Oliv4945/Photokey/images/Readme.md

# Setup
Install [PythonMagick] (https://wiki.python.org/moin/ImageMagick) from [source](http://www.imagemagick.org/download/python/) or your distribution package manager.  

* Debian: `apt install python3-pythonmagick`
