Oliv4945/Photokey/documentation/CR2450 holder.jpg

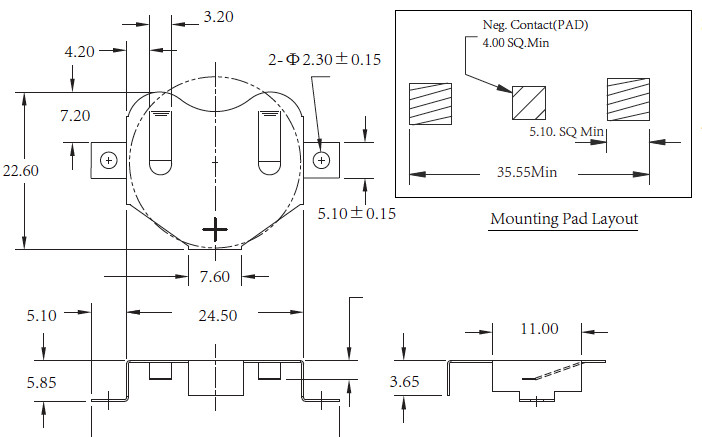
documentation/CR2450 holder.jpg
