Oliv4945/Photokey/hardware/hardware.kicad_pcb

## KiCad design hardware/hardware.kicad_pcb (2019-12-13)

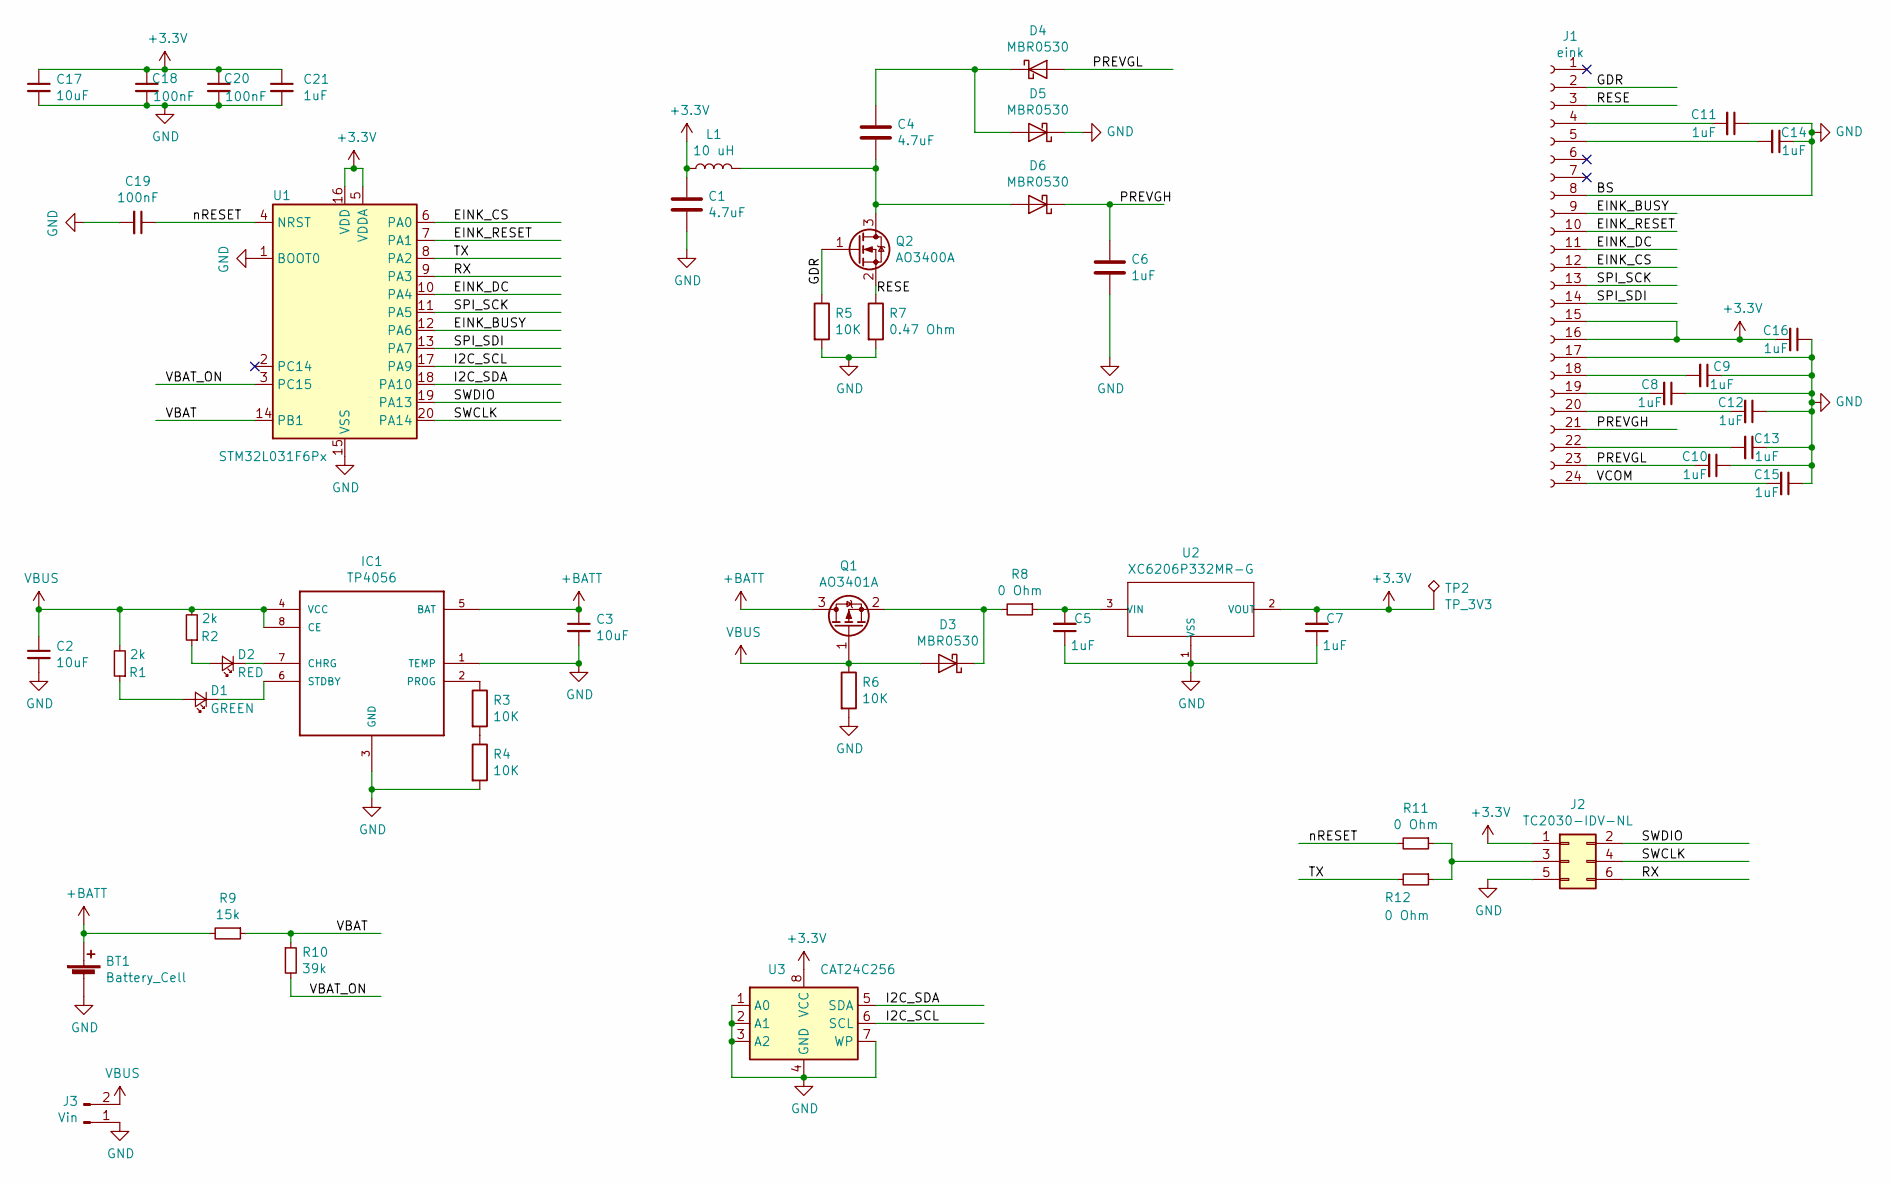
[picture p2: schematic hardware.sch]

Parts:
BT1: Battery_Cell; 2450
C1, C4: 4.7uF; C_1206_3216Metric; LCSC C29823
C2, C3, C17: 10uF; C_0805_2012Metric; LCSC C15850
C5, C6, C7, C8, C9, C10, C11, C12, C13, C14, C15, C16, C21: 1uF; C_0603_1608Metric; LCSC C15849
C18, C19, C20: 100nF; C_0402_1005Metric; LCSC C1525
D1: GREEN; D_0603_1608Metric; LCSC C72043
D2: RED; D_0603_1608Metric; LCSC C2286
D3, D4, D5, D6: MBR0530; D_SOD-123; LCSC C232832
IC1: TP4056; SOP-8; LCSC C16581
J1: eink; FPC_24
J2: TC2030-IDV-NL; TC2030-MCP-NL
J3: Vin; PinHeader_1x02_P2.54mm_Vertical
L1: 10 uH; L_1210_3225Metric; LCSC C86069
Q1: AO3401A; SOT-23; LCSC C15127
Q2: AO3400A; SOT-23; LCSC C20917
R1, R2: 2k; R_0402_1005Metric; LCSC C4109
R3, R4, R5, R6: 10K; R_0402_1005Metric; LCSC C25744
R7: 0.47 Ohm; R_0603_1608Metric; LCSC C23411
R8, R11, R12: 0 Ohm; R_0402_1005Metric; LCSC C21189
R9: 15k; R_0402_1005Metric; LCSC C25756
R10: 39k; R_0402_1005Metric; LCSC C25783
TP2: TP_3V3; TestPoint_Pad_D1.5mm
U1: STM32L031F6Px; TSSOP-20_4.4x6.5mm_P0.65mm; LCSC C115208
U2: XC6206P332MR-G; SOT-23; LCSC C5446
U3: CAT24C256; SOIC-8_3.9x4.9mm_P1.27mm; LCSC C6482

Connections:
+3V3: C1.1, C7.2, C16.2, C17.1, C18.1, C20.1, C21.1, J1.15, J1.16, J2.1, L1.1, TP2.1, U1.5 (VDDA), U1.16 (VDD), U2.2 (VOUT), U3.8 (VCC)
+BATT: BT1.1 (+), C3.1, IC1.5 (BAT), Q1.3 (D), R9.2
/EINK_BUSY: J1.9, U1.12 (PA6)
/EINK_CS: J1.12, U1.6 (PA0)
/EINK_DC: J1.11, U1.10 (PA4)
/EINK_RESET: J1.10, U1.7 (PA1)
/GDR: J1.2, Q2.1 (G), R5.1
/I2C_SCL: U1.17 (PA9), U3.6 (SCL)
/I2C_SDA: U1.18 (PA10), U3.5 (SDA)
/PREVGH: C6.1, D6.1 (K), J1.21
/PREVGL: C10.2, D4.2 (A), J1.23
/RESE: J1.3, Q2.2 (S), R7.1
/RX: J2.6, U1.9 (PA3)
/SPI_SCK: J1.13, U1.11 (PA5)
/SPI_SDI: J1.14, U1.13 (PA7)
/SWCLK: J2.4, U1.20 (PA14)
/SWDIO: J2.2, U1.19 (PA13)
/TX: R12.2, U1.8 (PA2)
/VBAT: R9.1, R10.1, U1.14 (PB1)
/VBAT_ON: R10.2, U1.3 (PC15)
/VCOM: C15.2, J1.24
/nRESET: C19.1, R11.2, U1.4 (NRST)
GND: BT1.2 (-), C1.2, C2.2, C3.2, C5.1, C6.2, C7.1, C8.1, C9.1, C10.1, C11.1, C12.1, C13.1, C14.1, C15.1, C16.1, C17.2, C18.2, C19.2, C20.2, C21.2, D5.1 (K), IC1.1 (TEMP), IC1.3 (GND), J1.8, J1.17, J2.5, J3.1, R4.2, R5.2, R6.2, R7.2, U1.1 (BOOT0), U1.15 (VSS), U2.1 (VSS), U3.1 (A0), U3.2 (A1), U3.3 (A2), U3.4 (GND), U3.7 (WP)
unnamed: C4.1, D4.1 (K), D5.2 (A)
unnamed: C4.2, D6.2 (A), L1.2, Q2.3 (D)
unnamed: C5.2, R8.1, U2.3 (VIN)
unnamed: C8.2, J1.19
unnamed: C9.2, J1.18
unnamed: C11.2, J1.4
unnamed: C12.2, J1.20
unnamed: C13.2, J1.22
unnamed: C14.2, J1.5
unnamed: D1.1 (K), IC1.6 (STDBY)
unnamed: D1.2 (A), R1.1
unnamed: D2.1 (K), IC1.7 (CHRG)
unnamed: D2.2 (A), R2.1
unnamed: D3.1 (K), Q1.2 (S), R8.2
unnamed: IC1.2 (PROG), R3.1
unnamed: J2.3, R11.1, R12.1
unnamed: R3.2, R4.1
VBUS: C2.1, D3.2 (A), IC1.4 (VCC), IC1.8 (CE), J3.2, Q1.1 (G), R1.2, R2.2, R6.1

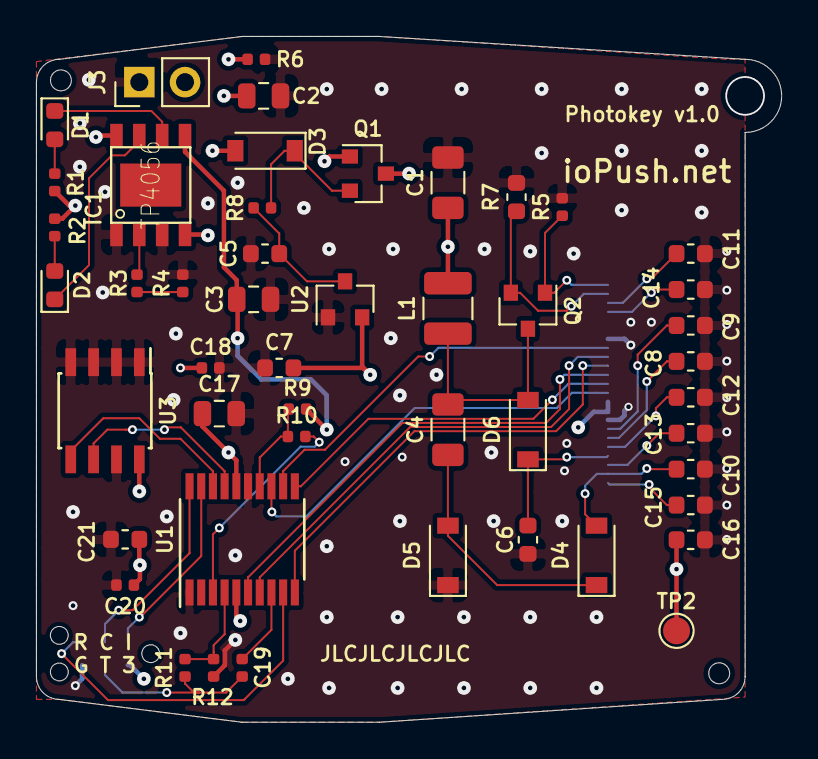
[picture p3: board hardware.kicad_pcb from above]

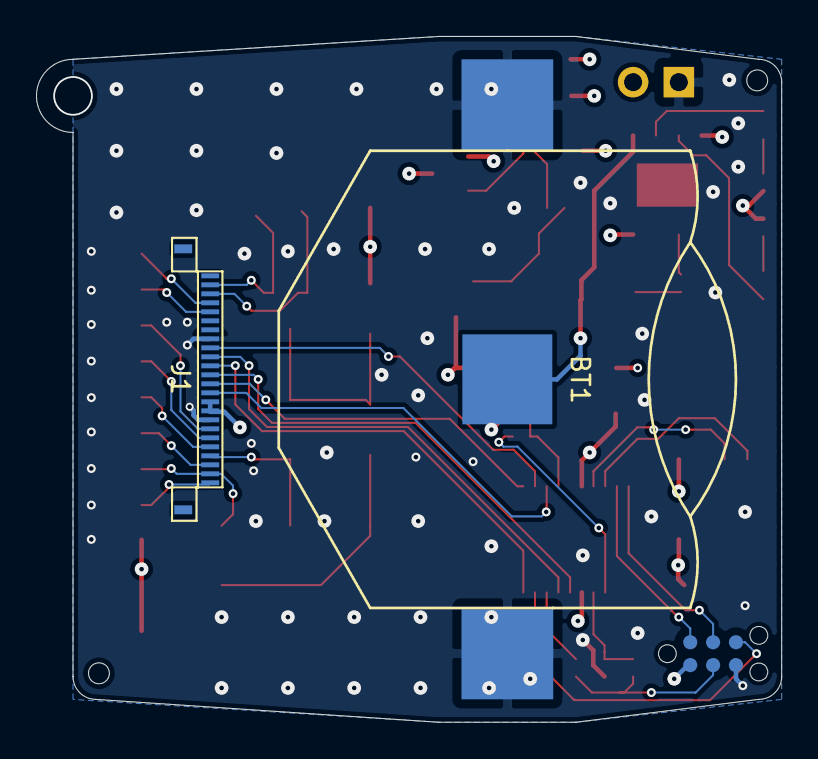
[picture p4: board hardware.kicad_pcb from below]

Board: 4 copper layers, 41.4 x 38.1 mm, 51 parts (3 on the bottom side), 41 nets.
