Oliv4945/Photokey/software/Src/main.c

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

/* Includes ------------------------------------------------------------------*/
#include "main.h"
#include "adc.h"
#include "i2c.h"
#include "usart.h"
#include "spi.h"
#include "gpio.h"

/* USER CODE BEGIN Includes */
#include "eeprom.h"
#include "epd.h"

/* USER CODE END Includes */


void SystemClock_Config(void);
/**
  * @brief  The application entry point.
  * @retval int
  */
int main(void)
{
  /* USER CODE BEGIN 1 */
  // TODO: volatile to be removed after test
  volatile float battery_value;

  /* USER CODE END 1 */
  

  /* MCU Configuration--------------------------------------------------------*/

  /* Reset of all peripherals, Initializes the Flash interface and the Systick. */
  HAL_Init();

  /* Configure the system clock */
  SystemClock_Config();

  /* Initialize all configured peripherals */
  MX_GPIO_Init();
  MX_I2C1_Init();
  MX_SPI1_Init();
  MX_ADC_Init();
  MX_LPUART1_UART_Init();
  /* USER CODE BEGIN 2 */

  // TODO: Read to be tested
  battery_value = read_battery();
  //eeprom_write_byte(0x00, 0x12);
  //eeprom_write_byte(0x01, 0x23);
  //eeprom_write_byte(0x02, 0x56);
  //uint8_t buffer[3];
  //eeprom_read_bytes(0x00, buffer, 3);

// EPD test
  EPD_init_4Gray(); //EPD init 4 Gray
  full_display(pic_earth);
  EPD_sleep(); //Enter deep sleep mode
	HAL_Delay(30);
/*
  // EPD test
  EPD_init_4Gray(); //EPD init 4 Gray
  full_display(pic_4bit);
  EPD_sleep(); //Enter deep sleep mode
	HAL_Delay(30);
		
  //4 gray picture
  EPD_init_4Gray(); //EPD init 4 Gray
  full_display(pic_display_4bit); //pic1
  EPD_sleep(); //Enter deep sleep mode
  HAL_Delay(30);
*/
  /* USER CODE END 2 */

  /* Infinite loop */
  /* USER CODE BEGIN WHILE */
  while (1)
  {
    /* USER CODE END WHILE */

    /* USER CODE BEGIN 3 */
  }
  /* USER CODE END 3 */
}

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
