Oliv4945/Photokey/software/Inc/main.h

#define VBAT_ON_Pin GPIO_PIN_15
#define VBAT_ON_GPIO_Port GPIOC
#define EINK_CS_Pin GPIO_PIN_0
#define EINK_CS_GPIO_Port GPIOA
#define EINK_RESET_Pin GPIO_PIN_1
#define EINK_RESET_GPIO_Port GPIOA
#define EINK_DC_Pin GPIO_PIN_4
#define EINK_DC_GPIO_Port GPIOA
#define SPI_SCK_Pin GPIO_PIN_5
#define SPI_SCK_GPIO_Port GPIOA
#define EINK_BUSY_Pin GPIO_PIN_6
#define EINK_BUSY_GPIO_Port GPIOA
#define SPI_SDI_Pin GPIO_PIN_7
#define SPI_SDI_GPIO_Port GPIOA
#define VBAT_Pin GPIO_PIN_1
#define VBAT_GPIO_Port GPIOB
#define I2C_SCL_Pin GPIO_PIN_9
#define I2C_SCL_GPIO_Port GPIOA
#define I2C_SDA_Pin GPIO_PIN_10
#define I2C_SDA_GPIO_Port GPIOA
