Oliv4945/Photokey/software/Src/adc.c

/**
  ******************************************************************************
  * File Name          : ADC.c
  * Description        : This file provides code for the configuration
  *                      of the ADC instances.
  ******************************************************************************
  * @attention
  *
  * <h2><center>&copy; Copyright (c) 2020 STMicroelectronics.
  * All rights reserved.</center></h2>
  *
  * This software component is licensed by ST under BSD 3-Clause license,
  * the "License"; You may not use this file except in compliance with the
  * License. You may obtain a copy of the License at:
  *                        opensource.org/licenses/BSD-3-Clause
  *
  ******************************************************************************
  */

/* Includes ------------------------------------------------------------------*/
#include "adc.h"

ADC_HandleTypeDef hadc;

/* ADC init function */
void MX_ADC_Init(void)
{
  ADC_ChannelConfTypeDef sConfig = {0};

  /** Configure the global features of the ADC (Clock, Resolution, Data Alignment and number of conversion) 
  */
  hadc.Instance = ADC1;
  hadc.Init.OversamplingMode = DISABLE;
  hadc.Init.ClockPrescaler = ADC_CLOCK_SYNC_PCLK_DIV1;
  hadc.Init.Resolution = ADC_RESOLUTION_12B;
  hadc.Init.SamplingTime = ADC_SAMPLETIME_7CYCLES_5;
  hadc.Init.ScanConvMode = ADC_SCAN_DIRECTION_FORWARD;
  hadc.Init.DataAlign = ADC_DATAALIGN_RIGHT;
  hadc.Init.ContinuousConvMode = DISABLE;
  hadc.Init.DiscontinuousConvMode = DISABLE;
  hadc.Init.ExternalTrigConvEdge = ADC_EXTERNALTRIGCONVEDGE_NONE;
  hadc.Init.ExternalTrigConv = ADC_SOFTWARE_START;
  hadc.Init.DMAContinuousRequests = DISABLE;
  hadc.Init.EOCSelection = ADC_EOC_SINGLE_CONV;
  hadc.Init.Overrun = ADC_OVR_DATA_PRESERVED;
  hadc.Init.LowPowerAutoWait = DISABLE;
  hadc.Init.LowPowerFrequencyMode = DISABLE;
  hadc.Init.LowPowerAutoPowerOff = DISABLE;
  if (HAL_ADC_Init(&hadc) != HAL_OK)
  {
    Error_Handler();
  }
  /** Configure for the selected ADC regular channel to be converted. 
  */
  sConfig.Channel = ADC_CHANNEL_9;
  sConfig.Rank = ADC_RANK_CHANNEL_NUMBER;
  if (HAL_ADC_ConfigChannel(&hadc, &sConfig) != HAL_OK)
  {
    Error_Handler();
  }

}

void HAL_ADC_MspInit(ADC_HandleTypeDef* adcHandle)
{

  GPIO_InitTypeDef GPIO_InitStruct = {0};
  if(adcHandle->Instance==ADC1)
  {
    /* ADC1 clock enable */
    __HAL_RCC_ADC1_CLK_ENABLE();
  
    __HAL_RCC_GPIOB_CLK_ENABLE();
    /**ADC GPIO Configuration    
    PB1     ------> ADC_IN9 
    */
    GPIO_InitStruct.Pin = VBAT_Pin;
    GPIO_InitStruct.Mode = GPIO_MODE_ANALOG;
    GPIO_InitStruct.Pull = GPIO_NOPULL;
    HAL_GPIO_Init(VBAT_GPIO_Port, &GPIO_InitStruct);

  }
}

void HAL_ADC_MspDeInit(ADC_HandleTypeDef* adcHandle)
{

  if(adcHandle->Instance==ADC1)
  {
    /* Peripheral clock disable */
    __HAL_RCC_ADC1_CLK_DISABLE();
  
    /**ADC GPIO Configuration    
    PB1     ------> ADC_IN9 
    */
    HAL_GPIO_DeInit(VBAT_GPIO_Port, VBAT_Pin);

  }
} 

/* USER CODE BEGIN 1 */
static uint16_t adc_read_channel(ADC_HandleTypeDef *hadc, uint8_t channel)
{
  uint16_t value;
  ADC_ChannelConfTypeDef sConfig = {0};
  sConfig.Channel = channel;

  if (HAL_ADC_ConfigChannel(hadc, &sConfig) != HAL_OK)
  {
    Error_Handler();
  }

  if (HAL_ADC_Start(hadc) != HAL_OK)
  {
    Error_Handler();
  }

  // TODO: More accurate timeout
  if (HAL_ADC_PollForConversion(hadc, 100) != HAL_OK)
  {
    Error_Handler();
  }
  while ((HAL_ADC_GetState(hadc) & HAL_ADC_STATE_REG_EOC) != HAL_ADC_STATE_REG_EOC)
  {
  }
  value = HAL_ADC_GetValue(hadc);

  if (HAL_ADC_Stop(hadc) != HAL_OK)
  {
    Error_Handler();
  }

  return value;
}

float read_battery()
{
  float battery_value;
  HAL_GPIO_WritePin(VBAT_ON_GPIO_Port, VBAT_ON_Pin, 0);
  // Voltage divider: 39/(39+15)
  // Formula: value = adc_read * 3.3 (Vref) / 2^12 * voltage divier
  battery_value = ((float)adc_read_channel(&hadc, 9)) * 3.3 / 4096 * 54 / 39;
  // TODO: IO should be set back to open drain input

  return battery_value;
}
/* USER CODE END 1 */

/************************ (C) COPYRIGHT STMicroelectronics *****END OF FILE****/
