Oliv4945/Photokey/software/epd/Display_EPD_W21_spi.h

#ifndef _MCU_SPI_H_
#define _MCU_SPI_H_
#include "main.h"
#include "epd.h"

#define EPD_W21_SPI_SPEED 0x02

//#define EPD_W21_VPP_0	P4 &= ~0x80
//#define EPD_W21_VPP_1	P4 |= 0x80

#define EPD_W21_MOSI_0	HAL_GPIO_WritePin(SPI_SDI_GPIO_Port, SPI_SDI_Pin, GPIO_PIN_RESET)
#define EPD_W21_MOSI_1	HAL_GPIO_WritePin(SPI_SDI_GPIO_Port, SPI_SDI_Pin, GPIO_PIN_SET)

#define EPD_W21_CLK_0	HAL_GPIO_WritePin(SPI_SCK_GPIO_Port, SPI_SCK_Pin, GPIO_PIN_RESET)
#define EPD_W21_CLK_1	HAL_GPIO_WritePin(SPI_SCK_GPIO_Port, SPI_SCK_Pin, GPIO_PIN_SET)

#define EPD_W21_CS_0	HAL_GPIO_WritePin(EINK_CS_GPIO_Port, EINK_CS_Pin, GPIO_PIN_RESET)
#define EPD_W21_CS_1	HAL_GPIO_WritePin(EINK_CS_GPIO_Port, EINK_CS_Pin, GPIO_PIN_SET)

#define EPD_W21_DC_0	HAL_GPIO_WritePin(EINK_DC_GPIO_Port, EINK_DC_Pin, GPIO_PIN_RESET)
#define EPD_W21_DC_1	HAL_GPIO_WritePin(EINK_DC_GPIO_Port, EINK_DC_Pin, GPIO_PIN_SET)

#define EPD_W21_RST_0	HAL_GPIO_WritePin(EINK_RESET_GPIO_Port, EINK_RESET_Pin, GPIO_PIN_RESET)
#define EPD_W21_RST_1	HAL_GPIO_WritePin(EINK_RESET_GPIO_Port, EINK_RESET_Pin, GPIO_PIN_SET)

// TODO: Not required as BS is grounded in hardware
#define EPD_W21_BS_0	asm ("nop");
//#define EPD_W21_BS_1	P2 |= 0x01

//#define isEPD_W21_BUSY GPIO_ReadOutputDataBit(GPIOE, GPIO_Pin_13) // for solomen solutions
#define isEPD_W21_BUSY HAL_GPIO_ReadPin(EINK_BUSY_GPIO_Port, EINK_BUSY_Pin)

extern SPI_HandleTypeDef hspi1;

extern void driver_delay_us(unsigned int xus);
extern void driver_delay_xms(unsigned long xms);

void SPI_Write(unsigned char value);
void EPD_W21_WriteDATA(unsigned char command);
void EPD_W21_WriteCMD(unsigned char command);
void EPD_W21_WriteCMD_p1(unsigned char command,unsigned char para);
void EPD_W21_WriteCMD_p2(unsigned char command,unsigned char para1,unsigned char para2);
void EPD_W21_Write(unsigned char *value, unsigned char datalen);

void EPD_W21_WriteDispRam(unsigned char XSize,unsigned int YSize,
							unsigned char *Dispbuff);

void EPD_W21_WriteDispRamMono(unsigned char XSize,unsigned int YSize,
							unsigned char dispdata);
void EPD_W21_WriteDispRamVGray4(unsigned char XSize,unsigned int YSize);
void EPD_W21_WriteDispRamHGray4(unsigned char XSize,unsigned int YSize);
void EPD_W21_WriteDispRamChessboardMono(unsigned char XSize,
										unsigned int YSize,
										unsigned char Mode);
void EPD_W21_WriteDispRamVline(unsigned char XSize,unsigned int YSize);
void EPD_W21_WriteDispRamHline(unsigned char XSize,unsigned int YSize);
void EPD_W21_WriteDispRamDotArray(unsigned char XSize,unsigned int YSize);

#endif  //#ifndef _MCU_SPI_H_

/***********************************************************
						end file
***********************************************************/
