Oliv4945/Photokey/software/epd/Ap_29demo.h

//////////////////////////////////////full screen update LUT////////////////////////////////////////////
//0~3 gray
const unsigned char lut_vcom[] =
{
0x00	,0x0A	,0x00	,0x00	,0x00	,0x01,
0x60	,0x14	,0x14	,0x00	,0x00	,0x01,
0x00	,0x14	,0x00	,0x00	,0x00	,0x01,
0x00	,0x13	,0x0A	,0x01	,0x00	,0x01,
0x00	,0x00	,0x00	,0x00	,0x00	,0x00,
0x00	,0x00	,0x00	,0x00	,0x00	,0x00,
0x00	,0x00	,0x00	,0x00	,0x00	,0x00
				
};
//R21
const unsigned char lut_ww[] ={
0x40	,0x0A	,0x00	,0x00	,0x00	,0x01,
0x90	,0x14	,0x14	,0x00	,0x00	,0x01,
0x10	,0x14	,0x0A	,0x00	,0x00	,0x01,
0xA0	,0x13	,0x01	,0x00	,0x00	,0x01,
0x00	,0x00	,0x00	,0x00	,0x00	,0x00,
0x00	,0x00	,0x00	,0x00	,0x00	,0x00,
0x00	,0x00	,0x00	,0x00	,0x00	,0x00,
};
//R22H	r
const unsigned char lut_bw[] ={
0x40	,0x0A	,0x00	,0x00	,0x00	,0x01,
0x90	,0x14	,0x14	,0x00	,0x00	,0x01,
0x00	,0x14	,0x0A	,0x00	,0x00	,0x01,
0x99	,0x0C	,0x01	,0x03	,0x04	,0x01,
0x00	,0x00	,0x00	,0x00	,0x00	,0x00,
0x00	,0x00	,0x00	,0x00	,0x00	,0x00,
0x00	,0x00	,0x00	,0x00	,0x00	,0x00,
};
//R23H	w
const unsigned char lut_wb[] ={
0x40	,0x0A	,0x00	,0x00	,0x00	,0x01,
0x90	,0x14	,0x14	,0x00	,0x00	,0x01,
0x00	,0x14	,0x0A	,0x00	,0x00	,0x01,
0x99	,0x0B	,0x04	,0x04	,0x01	,0x01,
0x00	,0x00	,0x00	,0x00	,0x00	,0x00,
0x00	,0x00	,0x00	,0x00	,0x00	,0x00,
0x00	,0x00	,0x00	,0x00	,0x00	,0x00,
};
//R24H	b
const unsigned char lut_bb[] ={
0x80	,0x0A	,0x00	,0x00	,0x00	,0x01,
0x90	,0x14	,0x14	,0x00	,0x00	,0x01,
0x20	,0x14	,0x0A	,0x00	,0x00	,0x01,
0x50	,0x13	,0x01	,0x00	,0x00	,0x01,
0x00	,0x00	,0x00	,0x00	,0x00	,0x00,
0x00	,0x00	,0x00	,0x00	,0x00	,0x00,
0x00	,0x00	,0x00	,0x00	,0x00	,0x00,
};
