Oliv4945/Photokey/(commit log)

2019-12-09 Schematic done
    [hardware.kicad_pcb, hardware.sch]
2019-12-09 Add J1 connector
    [hardware.sch]
2019-12-11 Placed components
    [hardware.kicad_pcb, hardware.sch]
2019-12-13 Update voltage divider
    [hardware.sch]
2019-12-13 Board routed
    [hardware.kicad_pcb]
2019-12-13 Add production files
    [hardware-B_Cu.gbr, hardware-B_Mask.gbr, hardware-B_Paste.gbr, hardware-B_SilkS.gbr, hardware-Edge_Cuts.gbr, hardware-F_Cu.gbr, hardware-F_Mask.gbr, hardware-F_Paste.gbr]
2020-01-22 Fixed SPI to transmit only
    [Display_EPD_W21_spi.c, software.ioc]
